mromberg/cerberus/cerberus.jpg

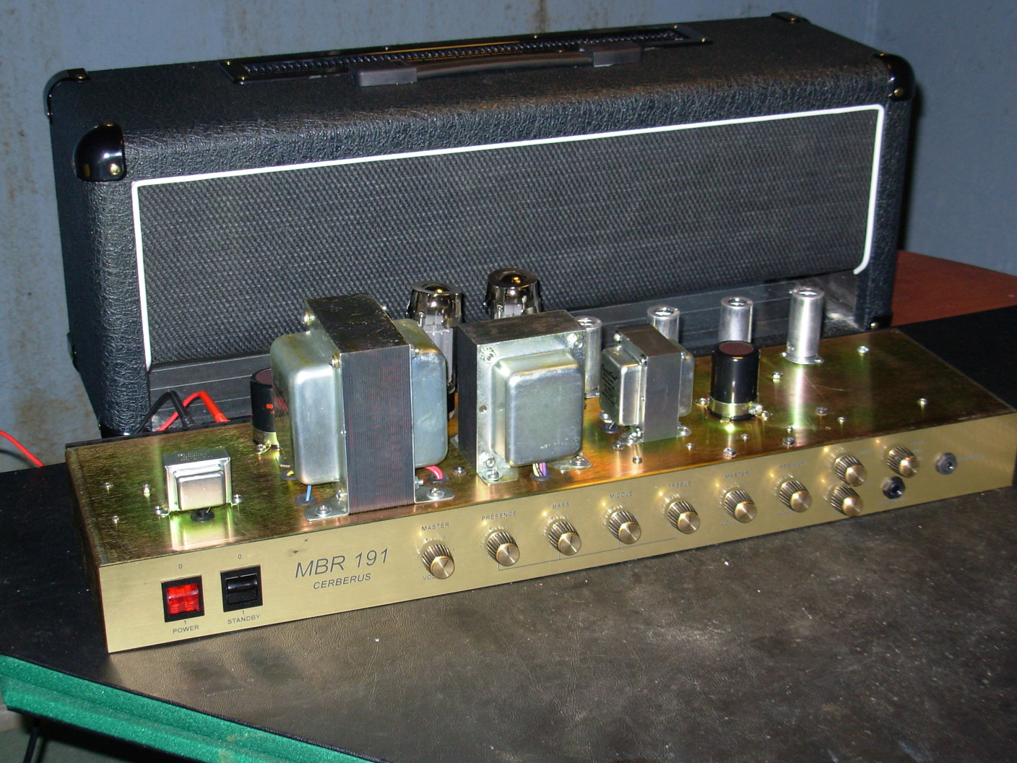
cerberus.jpg
