mromberg/cerberus/(list of files, cad)

Other CAD files:
layout.dxf
