mromberg/cerberus/layout.pdf

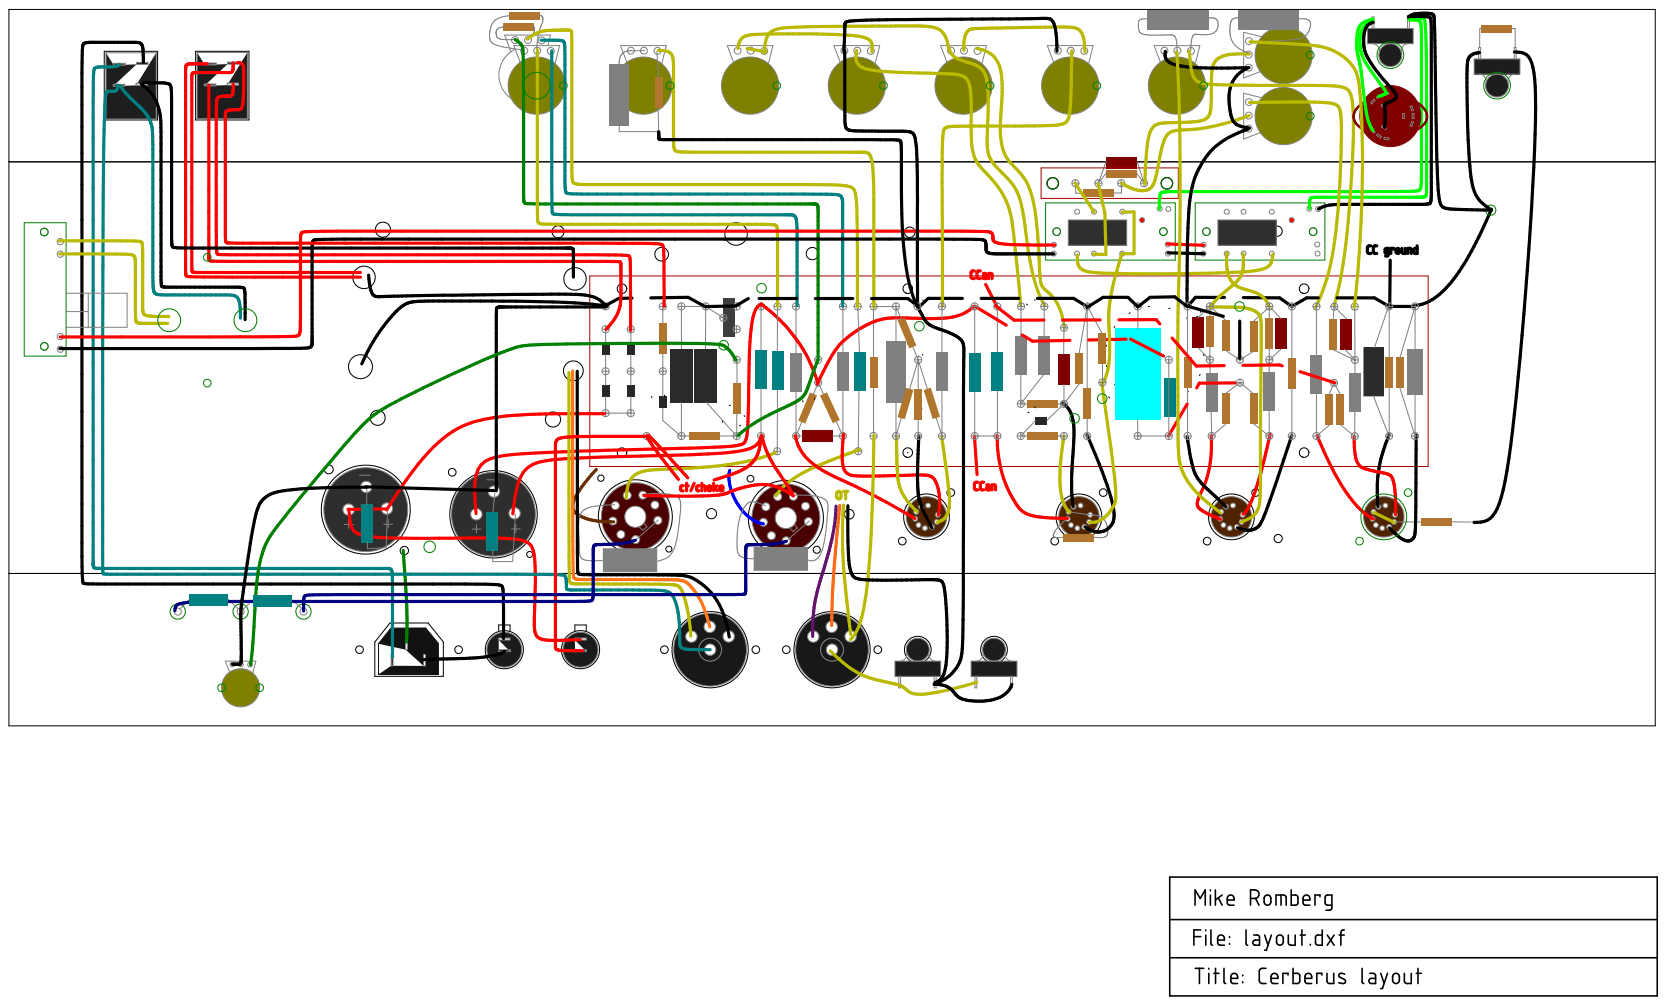
[picture p2: page 1]
