mromberg/cerberus/power.pdf

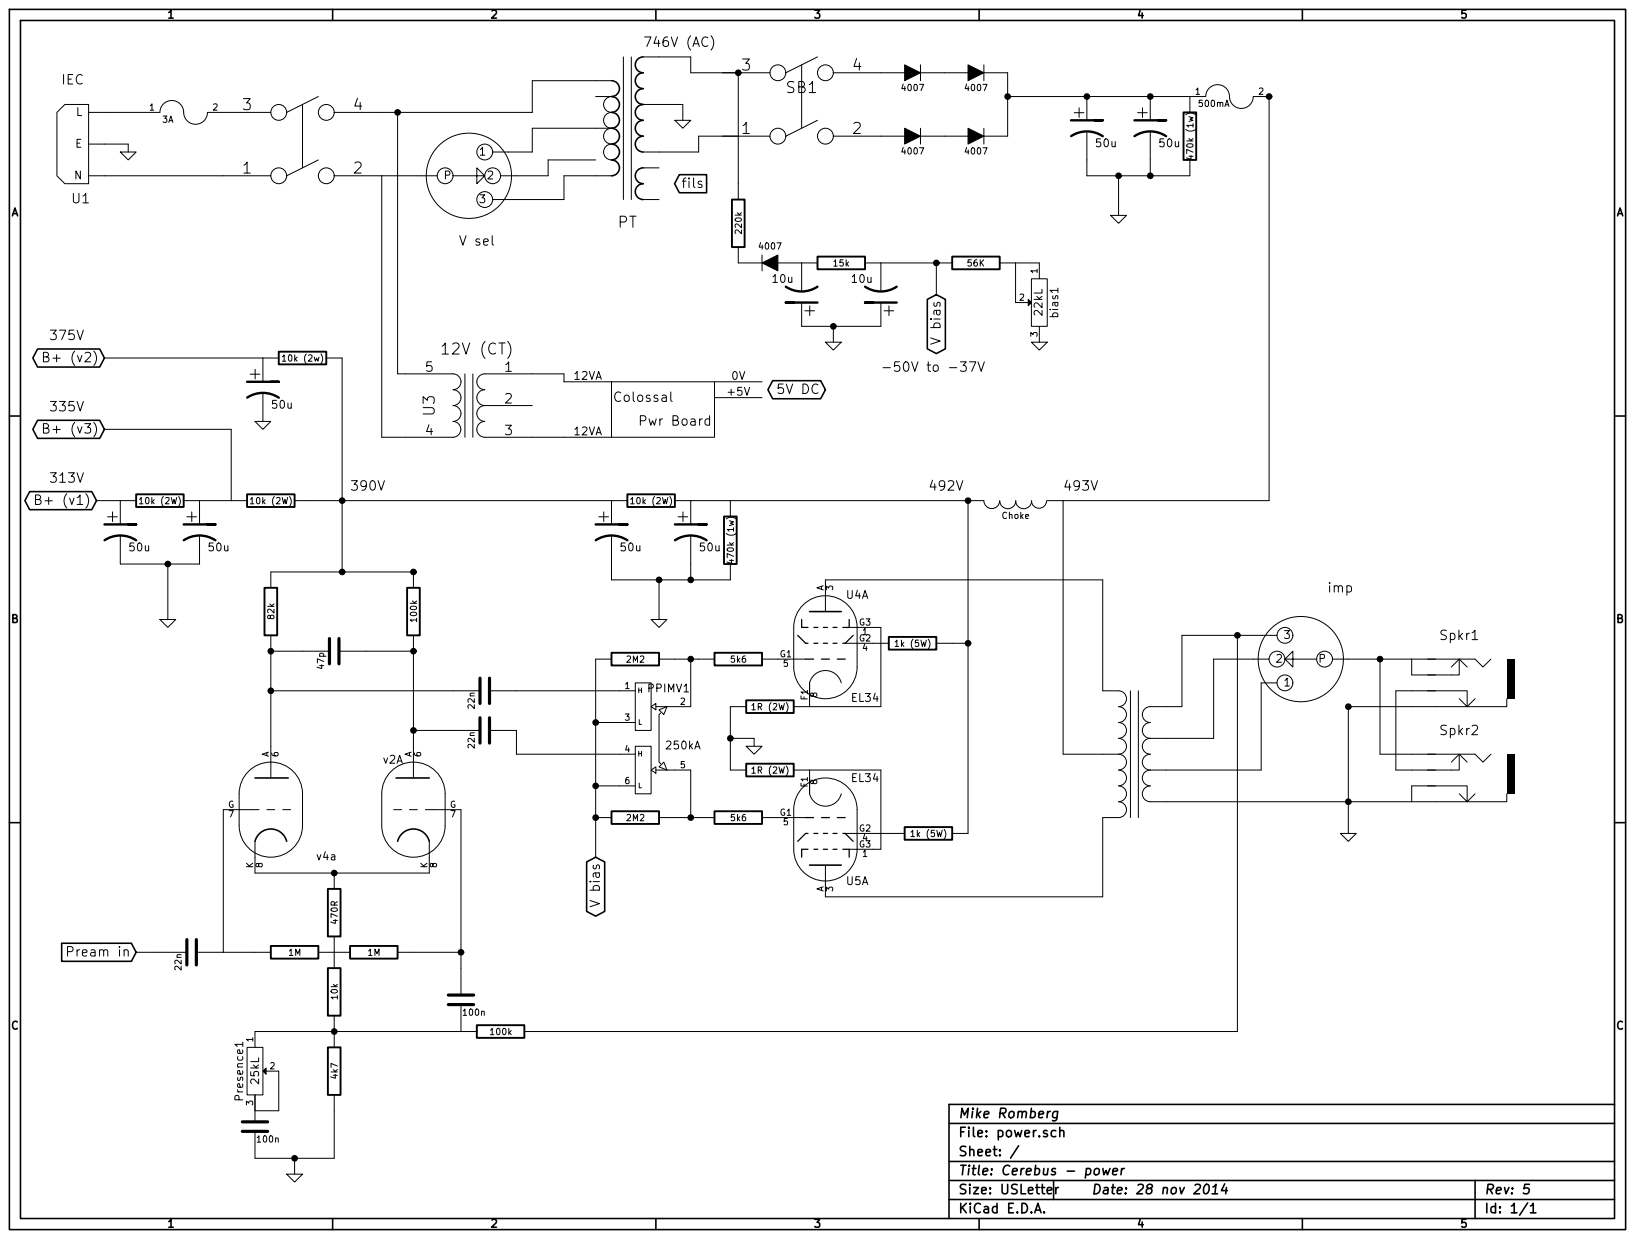
[picture p3: page 1]
