mromberg/cerberus/preamp.pdf

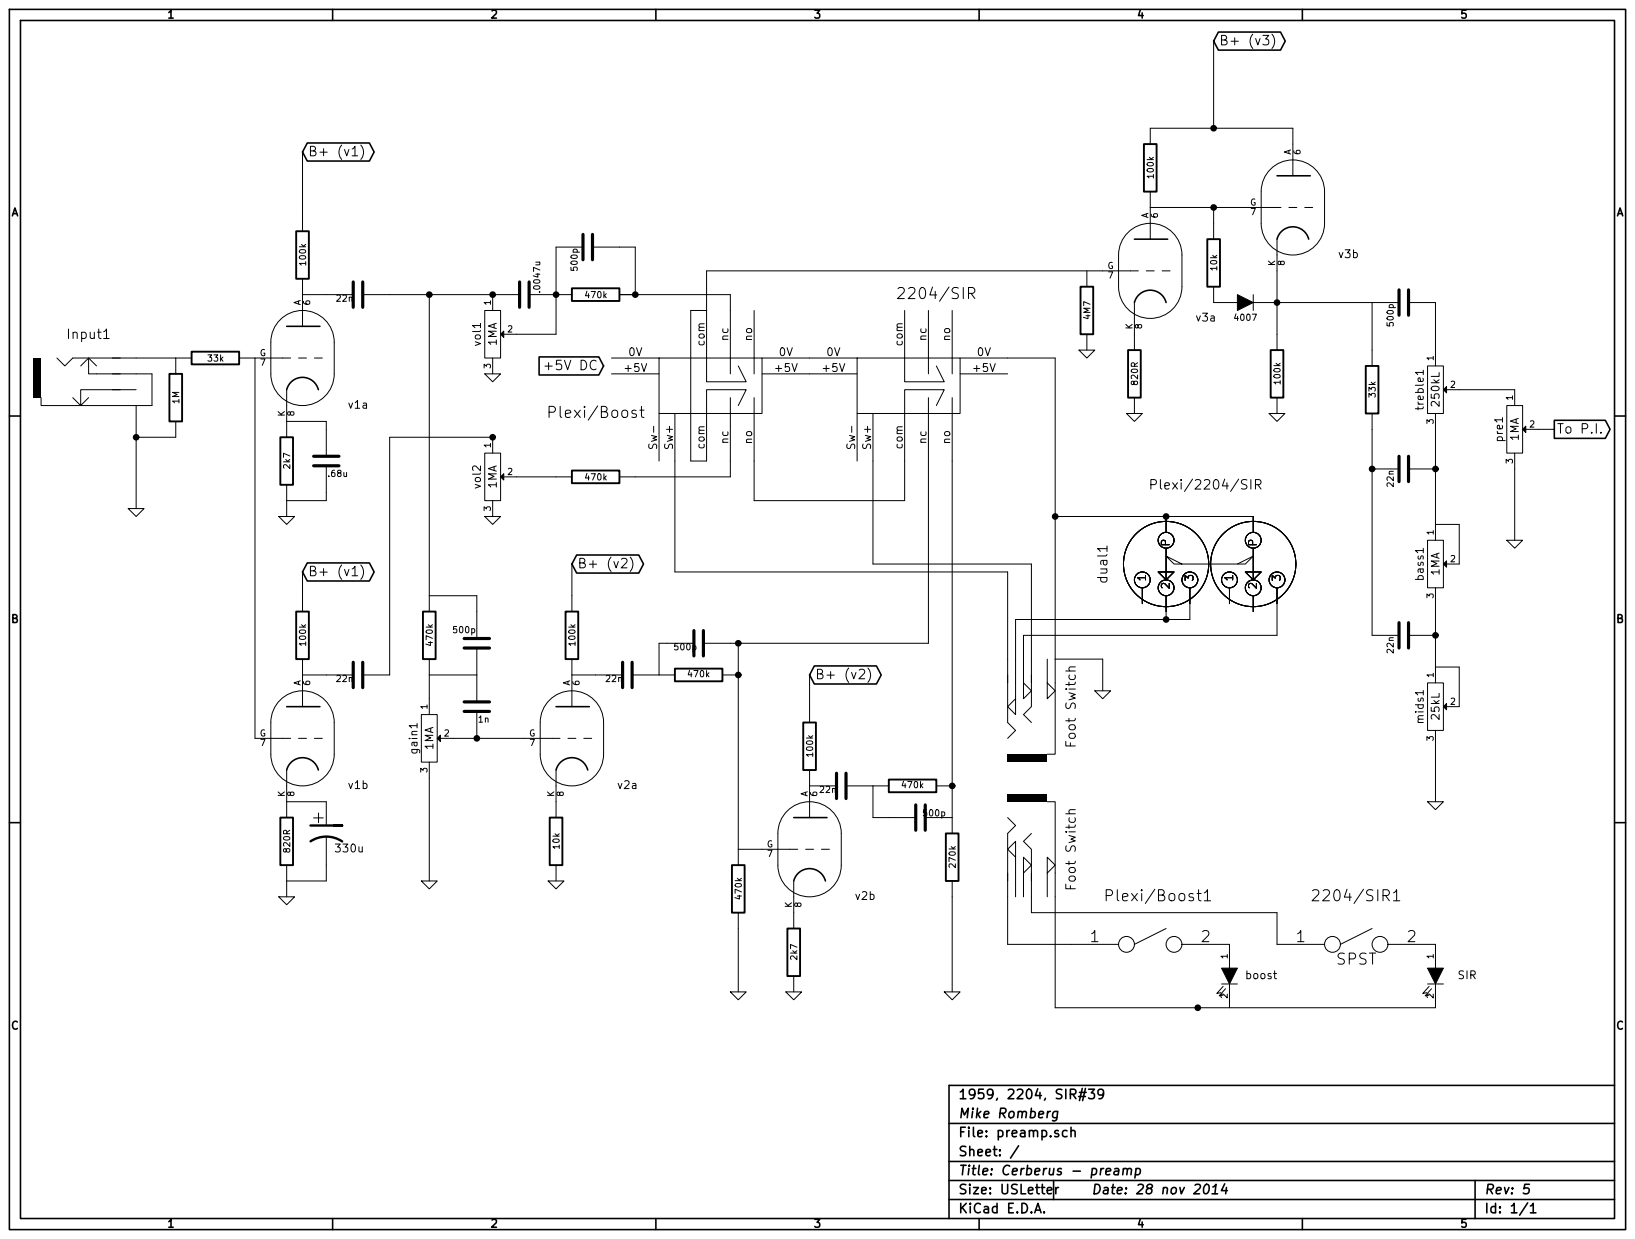
[picture p4: page 1]
