mromberg/cerberus/power.sch

## KiCad design power.sch (2016-03-30)

Schematic: power.sch

Parts:
C1, C3, C5, C10, C11, C14, C15: 50u
C2, C8, C9: 22n
C4, C7: 100n
C6: 47p
C12, C13: 10u
D1, D2, D3, D4, D5: 4007
F1: 3A
F2: 500mA
K1: COL_PWR
L1: Choke
PPIMV1: 250kA
Presence1: 25kL
R1, R2, R14: 10k (2W)
R3: 82k
R4, R9: 1M
R5: 10k (2w)
R6: 470R
R7: 10k
R8: 4k7
R10, R11: 100k
R12, R13: 2M2
R15, R25: 470k (1w)
R16: 220k
R17, R18: 5k6
R19, R20: 1R (2W)
R21: 15k
R22, R23: 1k (5W)
R24: 56K
SB1: DPST
SW1: DPST
Spkr1, Spkr2: CLIFF
T1: PT
T2: TRANSFORMER_6
U1: IEC
U2: V sel
U3: 12V (CT)
U4, U5: EL34; VALVE-OCTAL
U6: imp
bias1: 22kL
v1: v4a; VALVE-NOVAL_P
v2: v4b; VALVE-NOVAL_P

Notes on the sheet:
746V (AC)
493V
492V
390V
375V
335V
313V
-50V to -37V
