mromberg/cerberus/preamp.sch

## KiCad design preamp.sch (2016-03-30)

Schematic: preamp.sch

Parts:
2204/SIR1: SPST
C1: .68u
C2: 330u
C3, C4, C9, C11, C14, C15: 22n
C5, C8, C10, C12, C13: 500p
C6: 1n
C7: .0047u
D1: boost
D2: 4007
D3: SIR
Input1: CLIFF
J1, J2: Foot Switch
K1: Plexi/Boost
K2: 2204/SIR
Plexi/Boost1: SPST
R1: 1M
R2, R23: 33k
R3, R14: 2k7
R4, R19: 820R
R5, R6, R9, R15, R20, R22: 100k
R7, R10, R11, R12, R13, R16: 470k
R8, R21: 10k
R17: 270k
R18: 4M7
V1a1: v1a; VALVE-NOVAL_P
bass1: 1MA
dual1: Plexi/2204/SIR
gain1: 1MA
mids1: 25kL
pre1: 1MA
treble1: 250kL
v1b1: v1b; VALVE-NOVAL_P
v2a1: v2a; VALVE-NOVAL_P
v2a2: v2b; VALVE-NOVAL_P
v3a1: v3a; VALVE-NOVAL_P
v3b1: v3b; VALVE-NOVAL_P
vol1, vol2: 1MA
